Omar-Dahy/DGAS-Drowsy_Guard_Autopilot_System/photos/lighting_ecu.jpg

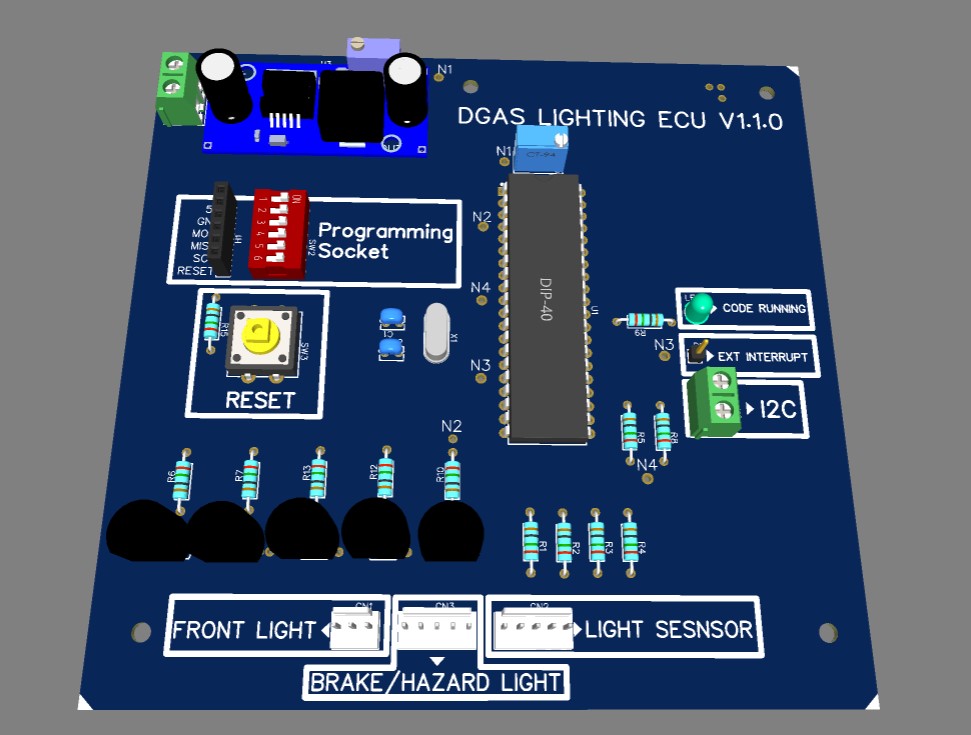
photos/lighting_ecu.jpg
