Omar-Dahy/DGAS-Drowsy_Guard_Autopilot_System/photos/motion_ecu.jpg

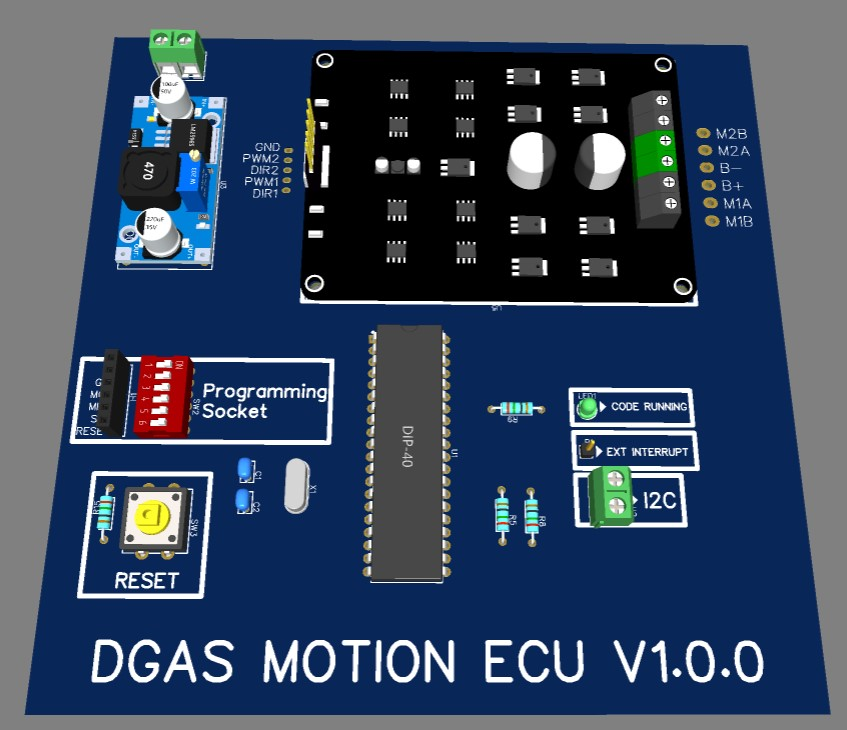
photos/motion_ecu.jpg
